ichigo-6301/mrtc-radar-tensor-codec-open/docs/en/architecture.md

# Architecture

[中文](../zh-CN/architecture.md) · [Back to README](../../README.en.md)

## System Contract

RDTC consumes Range-Doppler-Beam data produced by the FFT backend and sits between sensing-data generation and off-chip storage or transport; it does not implement the upstream FFT. Hardware implementation and performance optimization are encoder-centric, with packets intended for DDR, interconnect, or PC upload. A receiving PC/C decoder can reconstruct original I/Q from conventional self-describing packets. The RTL decoder provides protocol closure, bit-exact loopback, malformed-packet checking, and a hardware-decoder reference; no claim requires a production ASIC to instantiate it.

OFDM sensing and RDTC system context

| Contract | Public reference configuration |
|---|---|
| Block | `1024` I16Q16 samples and `4096` raw bytes |
| Packet | 64-byte self-describing header + RAW/Rice payload |
| Stream | main interface is 128-bit AXI-Stream; TLAST ends a packet and TUSER gives final-beat byte count |
| Identity | Frame, Block, and Range metadata preserve packet identity |
| Reconstruction | PC/C decodes conventional header-length packets; RTL decoding supplies bit-exact verification and a hardware reference |

See [Interfaces](interfaces.md) and [Bitstream Format](bitstream_format.md) for the external contract.

| Architecture layer | Published RTL |
|---|---|
| Complete control surface | [`mrtc_top`](../../rtl/top/mrtc_top.sv) plus [`mrtc_axi_lite_reg_block`](../../rtl/top/mrtc_axi_lite_reg_block.sv) |
| Single-Engine codec | [`mrtc_rdtc_codec_top`](../../rtl/rdtc/mrtc_rdtc_codec_top.sv) |
| DDR Multi-Engine | [`mrtc_rdtc_ddr_multiengine_wrapper`](../../rtl/rdtc/mrtc_rdtc_ddr_multiengine_wrapper.sv) |
| Bounded Direct-AXIS dual Engine (opt-in) | [`mrtc_rdtc_bounded_axis_multiengine_wrapper`](../../rtl/rdtc/mrtc_rdtc_bounded_axis_multiengine_wrapper.sv) |
| AXIS32 FPGA adaptation | [`mrtc_rdtc_axis32_wrapper`](../../rtl/rdtc/mrtc_rdtc_axis32_wrapper.sv) |

## Historical Full-Block Single-Engine Pipeline

Historical full-block/ping-pong Single-Engine encoder and decoder pipeline

The figure and this section describe the historical full-block/ping-pong profile, not the current bounded Direct-AXIS four-way shallow ring. They explain the stages used by the Lane4 Bitpacker and buffered Multi-Engine evidence.

A Single Engine progresses through these stages:

1. **Capture**: AXI input captures a complete block; ping-pong banks overlap reception of the next block with computation on the current block.
2. **Predict and map**: the block configuration selects ZERO or DELTA prediction, and I/Q residuals are independently mapped to non-negative values.
3. **Cost and select**: the prefix accumulator evaluates candidate `k` values, and the block policy selects `k`; only supporting encoder paths may fall back to RAW.
4. **Pack and frame**: the lane-parallel bitpacker emits the variable-length payload, while the header generator writes mode, length, and Frame/Block metadata.
5. **Decouple output**: the packet buffer isolates computation from AXI backpressure while preserving packet content and boundaries.
6. **Decode**: the header parser validates the format, and the Decoder reconstructs residuals and I/Q using the exact payload-bit count.

The DDR-backed `mrtc_rdtc_encoder_top` supports coding-cost-based RAW fallback. The small-buffer lane used by the AXIS32 wrapper has internal RAW fallback disabled. The architecture therefore presents RAW fallback as a path-dependent capability, not a universal wrapper guarantee.

## Descriptor/DDR Multi-Engine Wrapper

Descriptor and DDR-backed MRTC-RDTC Multi-Engine architecture

The Multi-Engine wrapper addresses system throughput when Single-Engine latency depends on block data:

- the round-robin dispatcher assigns complete blocks and never splits block-local state;
- every Engine has an independent feeder, codec state, and packet buffer;
- once the arbiter selects a packet, it holds the grant through that packet's `tlast`;
- beats from different packets do not interleave, while packet completion order may vary;
- header metadata preserves Frame/Block identity for indexed reconstruction at the consumer.

### Ordering Contract

| Property | Guarantee |
|---|---|
| Packet atomicity | verified: no beat interleaving within a packet |
| Input-order preservation | not guaranteed; data-dependent encoded length may change completion order |
| `OUTPUT_IN_ORDER=1` | not implemented; the public smoke requires this configuration to fail fast |
| Observed reorder event | the recorded workload did not directly observe one, so no triggered-reorder claim is made |
| Software reorder | metadata supports indexed reconstruction, but no software implementation PASS is claimed |

This choice avoids the buffering, control complexity, and head-of-line blocking of a hardware reorder buffer while leaving ordering policy explicit at the system-integration layer.

## Bounded Direct-AXIS Profile

Current bounded Direct-AXIS dual-Engine architecture

The opt-in Direct profile targets a lower-storage path for a bounded signal domain. One AXIS128 source sends 256 beats per block. A two-entry job table assigns complete blocks strictly to Engine 0, then Engine 1, while output remains input-job ordered and packet-locked through `tlast`.

Each Engine contains four `32x128` true-1RW ways, a two-entry registered ingress queue, a prefix-128 estimator, and the fixed-rate bounded bitpacker. The estimator observes accepted input directly and does not consume the RAM read port. The wrapper removes the DDR feeder and per-Engine payload commit stores; a global 16-beat FIFO absorbs short output stalls. The two Engines therefore contain `32,768` bulk ring bits, versus the prior payload-backed experiment's `180,224` bulk bits.

### Four-Way Shallow Input Ring

Bounded Direct-AXIS four-way shallow input ring

This ring belongs only to the bounded Direct-AXIS Encoder. It sits between AXIS input capture and the Bitpacker; it is neither an output FIFO nor the historical full-block ping-pong buffer. Each Engine holds `4 ways x 32 words x 128 bits = 2048 bytes`, exactly half of a 4096-byte block. The prefix estimator observes accepted input directly. `prefix-128` means the first 128 complex samples, or 32 AXIS128 beats, and is distinct from the ring's 128-beat capacity.

For a zero-based global AXIS word index:

```text
way    = floor(global_word_index / 32) mod 4
offset = global_word_index mod 32
```

| Global word | Physical way | Action |
|---|---:|---|
| `0-31` | 0 | first fill |
| `32-63` | 1 | first fill |
| `64-95` | 2 | first fill |
| `96-127` | 3 | first fill |
| `128-159` | 0 | reuse released slots |
| `160-191` | 1 | reuse released slots |
| `192-223` | 2 | reuse released slots |
| `224-255` | 3 | reuse released slots |

On a legal, non-fatal capture, each accepted input word writes its mapped slot and sets valid. An accepted ring read clears that slot's valid state so a later wrap can reuse it. The external response arrives at a fixed two-clock delay from the read request. Reads and writes may overlap on different ways. A true-1RW way cannot read and write in the same cycle even at different offsets; that condition raises a way conflict. Writing a still-valid slot or reading an invalid slot raises a ring error, promoted by the bounded Encoder to sticky fatal status.

### From An AXIS128 Source Word To A Variable Fragment

```text
ring response
    |
    v
P0   : accept one AXIS128 word / 4 complex samples
    |
P1R  : predictor selection and 8 signed residuals
    |
P1   : 8 residuals -> unsigned mapped symbols
    |
P2   : quotient, remainder and 8 component lengths
    |
P2S  : total length + parallel suffix-sum placement offsets
    |
P3A/P3P/P3B
     : unary/terminator/remainder generation
     : dynamic placement
     : balanced OR-tree token assembly
    |
    v
128-bit variable fragment + fragment length
    |
    v
width packer bit reservoir
    |
    v
bit-contiguous AXIS128 payload stream
```

The current bounded Direct profile fixes the ZERO predictor. Each signed 16-bit component passes through predictor selection and subtraction in P1R into a signed 18-bit residual container, then P1 maps it to an unsigned 18-bit symbol. P2 calculates all eight components' quotients, remainders, and `q+1+k*` lengths in parallel. P2S uses a logarithmic-depth suffix-sum structure to calculate total token length and each component's placement offset. P3A/P3P/P3B divide unary/terminator/remainder generation, dynamic shifts, and the wide balanced OR reduction across registered stages. The final 128-bit fragment carries an explicit bit length.

The width packer appends adjacent fragments to its bit reservoir. It emits a full AXIS128 payload word whenever at least 128 bits are available and emits a padded partial tail word at packet end. Fragment boundaries have no byte alignment. Source ring-read requests can therefore run at `II=1` while the compressed output still contains legal `TVALID` bubbles.

The per-source-word guard ensures that one source word never requires more than one 128-bit fragment in the bounded domain, allowing a one-word-per-cycle source cadence. If the total exceeds 128 bits, the Encoder reports `MRTC_ERR_BOUNDED_RICE_WORD` and fail-stops; it does not switch to RAW automatically.

The first 32 accepted AXIS128 beats contain the 128-sample prefix. During capture, the estimator accumulates `q+1+k` for every I/Q component and every candidate `k=0..15`, then selects the minimum accumulated prefix cost as `k*`; those first 32 beats remain in the ring. After `k*` becomes valid, the Bitpacker reads all 256 source words in original order, including the first 32 beats, and continues checking the per-word `<=128-bit` guard across the full block.

### Stream Timing Contract

See [Stream Timing](stream_timing.md#protocol-timing-contract) for the complete protocol relationship, the fixed Engine 0 / Block 0 ModelSim trace, payload bubbles, two deterministic backpressure holds, and dual-Engine packet-lock. That page separates ring-read source `II=1` from compressed-output `TVALID` duty and links the public CSV/Evidence directly.

This simplification is deliberately fail-stop:

- only `ZERO_RICE` with block-adaptive prefix `k` is accepted;
- every source-word fragment containing eight I/Q components must fit in `128` bits;
- one Engine issues all 256 ring reads at `II=1` after `k` becomes available;
- a same-way read/write collision, cadence failure, malformed block, or exhausted output credit raises sticky fatal status;
- without speculative payload storage, a fatal event can leave a partial packet externally visible, so producer and receiver state must be reset together.

The fixed regression observes about `277 cycles` of ordered packet service for a block arriving every `256 cycles`. That deficit accumulates and eventually triggers the illegal same-way condition reported as `MRTC_ERR_SRAM_WAY_CONFLICT`. This is workload evidence, not a protocol-cycle guarantee. The profile verifies bounded datapath behavior and implementation closure, but does not verify sustained zero-gap scheduling.

## Historical Buffered Throughput Scaling

The historical fixed-commit 256-block workload uses the Stage16D2 `785 cycles/block` single-Engine result as its same-workload reference. The 2/4-Engine buffered-wrapper runs achieve `397.52 / 197.41 cycles/block`, with efficiencies of `98.7368% / 99.4115%`. The 1-Engine reference was not rerun through the wrapper with `NUM_ENGINES=1`; one beam is defined as 256 blocks in this record.

Historical buffered Multi-Engine RTL simulation scaling

At an assumed 200 MHz, unrounded total-cycle values in the CSV project `1965.3022 / 3957.4642 beam/s`. These are RTL simulation projections, not FPGA implemented timing, measured board DDR throughput, or network throughput. The current public adaptation runs only a 2-Engine, 2-block correctness smoke and does not recompute the historical performance matrix.

Sources: [Multi-Engine evidence](../../evidence/rdtc_v1_multiengine_rtl.yaml) · [public CSV](../../evidence/data/rdtc_v1_multiengine_scaling.csv)

## Memory-Implementation Boundary

The historical `register-expanded` and `sram-macro` profiles preserve the same external AXI, packet, and functional contract while changing the prefix/sample-buffer binding. The Direct profile applies the same principle specifically to its eight `32x128` way memories: either all eight are expanded into standard cells or all eight bind to 1RW OpenRAM macros. The 16-beat output queue and control state remain registers. A memory-binding change does not remove buffering behavior or change packet bytes.

[See ASIC implementation and profile maturity](asic_implementation.md)
