ichigo-6301/mrtc-radar-tensor-codec-open/docs/zh-CN/interfaces.md

# 接口与集成入口

[English](../en/interfaces.md) · [返回首页](../../README.md)

## 应该实例化哪个模块

| 使用场景 | Canonical top | Filelist | 公开检查 |
|---|---|---|---|
| 完整受控 IP，AXI4-Lite 配置 + AXIS128 codec | [`mrtc_top`](../../rtl/top/mrtc_top.sv) | [`rdtc_v1.f`](../../flows/manifests/rdtc_v1.f) | `make integration-smoke` |
| 单 Engine 编码器 + 解码器 | [`mrtc_rdtc_codec_top`](../../rtl/rdtc/mrtc_rdtc_codec_top.sv) | [`rdtc_v1.f`](../../flows/manifests/rdtc_v1.f) | `make integration-smoke`；实例参考 [`tb_rdtc_codec_top_smoke`](../../tb/sv/tb_rdtc_codec_top_smoke.sv) |
| Descriptor/DDR feeder 驱动的 N Engine 压缩 | [`mrtc_rdtc_ddr_multiengine_wrapper`](../../rtl/rdtc/mrtc_rdtc_ddr_multiengine_wrapper.sv) | [`rdtc_v1_multiengine_smoke.f`](../../flows/manifests/rdtc_v1_multiengine_smoke.f) | `make multiengine-smoke` |
| 单路 AXIS128 输入的 bounded 双 Engine | [`mrtc_rdtc_bounded_axis_multiengine_wrapper`](../../rtl/rdtc/mrtc_rdtc_bounded_axis_multiengine_wrapper.sv) | [`rdtc_v1_bounded_direct.f`](../../flows/manifests/rdtc_v1_bounded_direct.f) | `make bounded-direct-rtl-smoke` 与 `make bounded-direct-rtl-identity-check` |
| 历史 Zynq trial 的 AXIS32 adaptation | [`mrtc_rdtc_axis32_wrapper`](../../rtl/rdtc/mrtc_rdtc_axis32_wrapper.sv) | [`rdtc_v1_fpga_wrapper_smoke.f`](../../flows/manifests/rdtc_v1_fpga_wrapper_smoke.f) | `make fpga-wrapper-smoke` |

通用新集成默认从 `mrtc_top` 开始；只需要 codec datapath、并由外部逻辑直接提供配置时使用 `mrtc_rdtc_codec_top`。DDR 与 bounded Direct-AXIS wrapper 都是 opt-in 集成面，并不替代带 AXI4-Lite 控制面的 `mrtc_top`。

## 固定数据合同

| 项目 | RDTC v1 合同 |
|---|---|
| 原始 sample | I16Q16 complex，I/Q 各为 signed 16-bit |
| Tensor flatten | `S[spatial/beam, doppler, range]`；Range 最快变化；由 producer 形成扁平序列 |
| Block | 1024 complex samples，4096 raw bytes |
| 主 datapath | 128-bit AXI-Stream，每拍 4 个 I16Q16 sample |
| Sample word | 每个 32-bit lane 为 `{Q[15:0], I[15:0]}`；字节为 little-endian I 后 Q |
| Packet | 64-byte little-endian header + variable-length payload |
| Codec mode | `RAW_BYPASS`、`ZERO_RICE`、`DELTA_RICE` |
| Tail bytes | TLAST 拍使用 `tuser[3:0] = valid_byte_count - 1`；主 AXIS128 不导出 TKEEP |

## Clock 与 Reset

公开 RTL 使用单一 `clk` 和低有效异步 datapath reset `rst_n`。`i_clear_status` 只清 completion/counter 统计，不清 sticky fatal status、不替代 reset，也不应被用来中断正在握手的 AXI-Stream transaction。所有 `tvalid/tready` 传输都在 `clk` 上升沿完成。

## AXI-Stream 编码 transaction

1. 在 block 第一个 beat 前锁定 codec、Rice 和 tensor metadata 配置。
2. 仅当 `s_axis_raw_tvalid && s_axis_raw_tready` 时提交输入 beat。
3. 按零起始编号，在 beat 255（第 256 拍）置 `s_axis_raw_tlast=1`；该 beat 仍包含 4 个有效 I16Q16 sample。
4. Encoder 先发送 64-byte header，再发送 payload。
5. 最后一个输出 beat 置 `m_axis_comp_tlast=1`，此时 `m_axis_comp_tuser[3:0]` 给出有效字节数减一；完整 16-byte 尾拍为 `15`。
6. 在正常非 fatal 路径，下游可以拉低 `m_axis_comp_tready`，packet 内容和边界保持到握手；fail-stop halt 是下文明确说明的例外。

Decoder 在 `s_axis_comp_*` 接收同一物理 packet 边界，并在 `m_axis_raw_*` 恢复 1024 个 I16Q16 sample。常规 C/RTL packet 由 header 给出 payload length；bounded Direct packet 由 TLAST/TUSER 给出物理长度。两者兼容性和当前 C decoder 缺口见[码流格式](bitstream_format.md#packet-length-contracts)。固定示例可运行 `make codec-demo`，其输入、packet 和解码输出 SHA256 记录在 [codec demo evidence](../../evidence/rdtc_v1_codec_demo.yaml)。接口握手与 Direct packet 服务时序见[流时序](stream_timing.md#protocol-timing-contract)。

## 关键参数

| Module | Parameter | 含义 |
|---|---|---|
| `mrtc_top` | `AXIS_DATA_W=128` | 公开主数据宽度；当前 RDTC v1 合同固定为 128 bit |
| `mrtc_top` | `AXIL_ADDR_W=12`, `AXIL_DATA_W=32` | 控制面地址与数据宽度 |
| codec/engine | `MRTC_K_POLICY_ARCH` | full-adaptive 或 prefix-fast `k` 选择架构 |
| 常规 codec/top 与历史 full-block profile | `PREFIX_SAMPLES=256` | 该路径的公开默认 prefix-fast 观察长度；不适用于 Direct profile |
| DDR wrapper | `NUM_ENGINES=2` | Engine 数量；公开回归覆盖 2/4 Engine 历史矩阵与 2 Engine adaptation smoke |
| DDR wrapper | `OUTPUT_IN_ORDER=0` | 唯一支持值；设为 `1` 会 fail-fast |
| Direct wrapper | `NUM_ENGINES=2`, `ENGINE_BOUNDED_WAY_COUNT=4` | 公开配置固定为双 Engine、共 8 个 way |
| Direct wrapper | `PREFIX_SAMPLES=128`, `OUTPUT_FIFO_DEPTH=16` | 固定 bounded prefix 与全局 output credit 深度 |

## Multi-Engine descriptor 与输出顺序

DDR wrapper 通过 `s_desc_*` 接收 raw address、Frame/Block ID、Range 起点、codec mode 和 tensor shape。每个 Engine 拥有独立 feeder、codec 和 packet buffer；输出 arbiter 一旦选中 packet，就保持该 Engine 直到 `tlast`，因此 packet 内不会 beat interleaving。

不同 block 的完成顺序不保证。Header 中的 Frame/Block metadata 提供 indexed software reconstruction 所需身份，但本仓库不声明软件 reorder 程序 PASS。`OUTPUT_IN_ORDER=1` 未实现并显式 fail-fast。

## Bounded Direct-AXIS 合同

Direct wrapper 分别接收 descriptor 与单路 `s_axis_raw_*`。Descriptor 包含 Block ID、Range 起点、Frame ID、tensor dimensions、codec/Rice 字段和 `last_block`，不包含 raw DDR 地址。每个 descriptor 精确预约一个 Engine，随后 256 个已握手 AXIS128 beat 全部属于该 descriptor；没有预约 descriptor 就发送数据属于 fatal。

公开合法配置为 `ZERO_RICE` 加 block-adaptive prefix `k`。RAW、DELTA、fixed `k`、过早/过晚 `tlast`、超过 128 bit 的 Rice word、`II=1` cadence 中断或同 way 读写冲突都会 fail closed。Descriptor 严格按 Engine `0 -> 1 -> 0 -> 1` 轮转；输出保持 job-table 顺序，并锁定到已握手的 `m_axis_comp_tlast`。Packet 内允许 `tvalid` 空拍，`tlast` 仍是唯一 packet boundary。

Direct 输入面是 bounded fail-stop 合同：当已预约 Engine 尚未 ready 时继续呈现 `s_axis_raw_tvalid=1` 会产生 `MRTC_ERR_BLOCK_NOT_READY`，而不是作为可无限保持的普通输入 backpressure。Producer 必须先完成合法 descriptor 预约，并只在该 Direct wrapper 允许的 ready 窗口送数。四路 ring 的容量、复用与冲突规则见[架构](architecture.md#four-way-shallow-input-ring)。

16-beat output FIFO 提供有限 backpressure credit。下游 stall 耗尽 emergency credit 后，`stat_error` sticky 为 `MRTC_ERR_OUTPUT_CREDIT`（`24`），wrapper 停止接收和输出。该路径没有 speculative payload commit store，已发送 beat 不能回滚；恢复必须用真实 `rst_n` 同时复位 wrapper 与下游 packet receiver。`i_clear_status` 只清 counter，不能恢复 fatal 状态。

## AXI4-Lite 控制面

`mrtc_top` 的 AXI4-Lite 接口提供 enable、soft reset、状态清除、codec 配置、tensor metadata、计数器、IRQ 和 capability。地址、位域和读写属性见 [寄存器表](register_map.md)；RTL [`mrtc_axi_lite_reg_block`](../../rtl/top/mrtc_axi_lite_reg_block.sv) 是最终接口权威。

## 集成检查清单

- 固定配置在一个 block transaction 内保持不变。
- 输入 `tlast` 与 1024-sample block 边界一致。
- 正常非 fatal 输出路径支持 `tready` backpressure 与 TLAST/TUSER 尾拍规则；Direct output-credit 耗尽属于 fail-stop，不是无限 backpressure。
- Packet 以 `tlast` 为原子边界，不按 block ID 假设天然有序。
- Direct profile 必须先提交合法 descriptor、满足 bounded codec 域、避免在低 ready 时呈现 input valid，并在任意非零 `stat_error` 后复位两端。
- 使用所选 top 对应的 tracked filelist，不手工遗漏 package 或 helper module。
- 在交付前运行对应 smoke，并确认工作树在 ignored build 产物之外保持干净。
