ichigo-6301/mrtc-radar-tensor-codec-open/vectors/rdtc_v1/smoke_axis_packing/README_vector.md

# smoke_axis_packing

RDTC v1 vector set with sample-major IQ Rice payload layout.

- Blocks: 1
- Total compressed bytes: 1470
- Raw bypass blocks: 0
- Compressed ZERO_RICE/DELTA_RICE blocks set MRTC_FLAG_SAMPLE_MAJOR_IQ.
- Case-level AXI control files use 128-bit words with per-word num_bytes and tlast.
