ichigo-6301/mrtc-radar-tensor-codec-open/vectors/rdtc_v1/smoke_random_noise/README_vector.md

# smoke_random_noise

RDTC v1 vector set with sample-major IQ Rice payload layout.

- Blocks: 1
- Total compressed bytes: 4160
- Raw bypass blocks: 1
- Compressed ZERO_RICE/DELTA_RICE blocks set MRTC_FLAG_SAMPLE_MAJOR_IQ.
- Case-level AXI control files use 128-bit words with per-word num_bytes and tlast.
