ichigo-6301/mrtc-radar-tensor-codec-open/evidence/rdtc_v1_bitpacker_pipeline_ab.yaml

title: RDTC v1 historical Bitpacker pipeline fixed-workload RTL A/B
status: verified
source_visibility: private_fixed_commits
public_evidence_scope: curated two-point payload and single-Engine steady-state CSV, fixed source/workload identities, metric derivations, and fresh ModelSim replay hashes
curated_data: evidence/data/rdtc_v1_bitpacker_pipeline_ab.csv
curated_data_sha256: 7836af2603305125d29bc30942bbf2a16bcfbaa2eb664d41cdcd36c07f28309d
tool: ModelSim SE-64 2020.4
workload:
  name: smoke_zero_sparse
  input: vectors/rdtc_v1/smoke_zero_sparse/axis_raw_in.hex
  input_sha256: db8e83367cd0219edd004d3f1ad4e35099afd5b906d6e26f4f976ca9affe4b46
  manifest: vectors/rdtc_v1/smoke_zero_sparse/manifest.json
  manifest_sha256: 1924010e24a27805b452039c62985b727b3356cc625f93539c115c3969b6c1cc
  expected_packet: vectors/rdtc_v1/smoke_zero_sparse/axis_comp_expected.hex
  expected_packet_sha256: 99dbb08d3df40b67653d1f4cb8500fe44e8f93a0e2ddf23f901678bca04d2ef9
  monitor_path: tb/sv/mrtc_encoder_latency_monitor.sv
  baseline_monitor_git_blob: f994a0b4f820b698bcc229d2cd6f4f0d06075f18
  optimized_monitor_git_blob: f994a0b4f820b698bcc229d2cd6f4f0d06075f18
metric_definition:
  name: payload_stream_cycles
  formula: packet_last_cycle - payload_first_valid_cycle + 1
  interval: inclusive
  packet_last_event: accepted packet TLAST
steady_state_metric_definition:
  name: single_engine_steady_state_cycles_per_block
  formula: average packet-completion spacing over the fixed 256-block stream
  interval: packet_last_cycle[n] - packet_last_cycle[n-1]
  scope: single Engine with prefix-during-capture enabled at both A/B points
steady_state_workload_identity:
  source_case: smoke_zero_sparse
  source_tree_git_sha: 2f361efc2ff32115d7cc2037d0bc7939da6d5d92
  identical_source_tree_at_commits:
    baseline: 327c463896bda94c60eb2b47d3c3dfc61a183367
    optimized: 2c1d9a75d2742659b604dd3f9c754096e196d132
    multiengine: 8628ee4d561bf4ee4a97a02c800e1c52c9e9a28a
  source_vector_path: vectors/rdtc_v1/smoke_zero_sparse/block_000_axis_raw_in.hex
  source_vector_git_blob: 88135ef82cfb15c601964fe1d9072b19e22421f5
  source_vector_sha256: db8e83367cd0219edd004d3f1ad4e35099afd5b906d6e26f4f976ca9affe4b46
  source_manifest_path: vectors/rdtc_v1/smoke_zero_sparse/manifest.json
  source_manifest_git_blob: 5f3821f7e52a15edeea5b1e37c4a6eef94f507e6
  source_manifest_sha256: 1924010e24a27805b452039c62985b727b3356cc625f93539c115c3969b6c1cc
  single_engine_generator:
    path: scripts/stage16c3_gen_latency_vectors.py
    git_blob: 585d7372faa58af44ec8df32a9e65f6a5f1b6c8b
    sha256: 42fac83943b1d13c65f1cb5d1981c0b6b31837f1182092b152c768be56c681f0
    generated_case: prefix_256_block_beam
    repeat_count: 256
    identical_at_baseline_and_optimized_commits: true
  multiengine_generator:
    source_commit: 8628ee4d561bf4ee4a97a02c800e1c52c9e9a28a
    path: scripts/stage16f1_gen_vectors.py
    git_blob: 4a9ec8bc7b8b0c55b1e1277b59ba9d9f20973d60
    sha256: 87eae094f9608003efbbcbd74edcbbb245aa555cea7874b94fe626fb0e0cc42f
    generated_case: prefix_256_block_beam
    repeat_count: 256
    reuses_source_vector_and_manifest: true
  public_multiengine_binding:
    evidence: evidence/rdtc_v1_multiengine_rtl.yaml
    curated_data: evidence/data/rdtc_v1_multiengine_scaling.csv
    engine_count: 1
    workload_blocks: 256
    effective_cycles_per_block: 785.00
    measurement_scope: imported Stage16D2 single-Engine reference; not a wrapper NUM_ENGINES=1 rerun
points:
  baseline:
    branch: stage16c3-prefix-during-capture
    source_commit: 327c463896bda94c60eb2b47d3c3dfc61a183367
    mode: PREFIX_FAST_STREAM_LENGTH_CAPTURE_PREFIX
    scenario: prefix_capture_zero_sparse
    source_latency_csv: docs/reports/data/stage16c3_latency/latency_per_block.csv
    source_latency_csv_git_blob: 5caec459dc0810e3bd54e75498fe61ba2bb8d6bb
    source_latency_csv_sha256: 974f6bd134e6a706e78746252a80239006f36609da8e74a130c640150e610d5c
    source_throughput_csv: docs/reports/data/stage16c3_latency/throughput_summary.csv
    source_throughput_csv_git_blob: 799cd70c9ea61155c6825c5aa22d61299a0e1aa3
    source_throughput_csv_sha256: beb06f66ab286a66647be4ef1fd24856b1d1f1bd9a4ec4ca7055ea9279b5fd27
    payload_first_valid_cycle: 1169
    packet_last_cycle: 8861
    payload_stream_cycles: 7693
    steady_state_scenario: prefix_capture_256_block_beam
    steady_state_blocks: 256
    steady_state_cycles_per_block: 8220
  optimized:
    branch: stage16d2-integrate-lane4-bitpacker
    source_commit: 2c1d9a75d2742659b604dd3f9c754096e196d132
    mode: PREFIX_FAST_STREAM_LENGTH_CAPTURE_PREFIX_LANE4_BPACK
    scenario: prefix_lane4_zero_sparse
    source_latency_csv: docs/reports/data/stage16d2_integrated_lane4/latency_per_block.csv
    source_latency_csv_git_blob: a222dff12da80292596c21521a26213b2b260de2
    source_latency_csv_sha256: d78a04854ff297e679a7ed030edd23b90564efc8d6fc3c41b992da8dffd966e3
    source_throughput_csv: docs/reports/data/stage16d2_integrated_lane4/throughput_summary.csv
    source_throughput_csv_git_blob: 1c7e12127ee5f030d496f1cec656ef94d058e556
    source_throughput_csv_sha256: 5f4558040382b439ce688bed749f13ea69994d61fd3e8931f72e703c328f5b7a
    source_packet_compare_csv: docs/reports/data/stage16d2_integrated_lane4/lane4_vs_legacy_packet_compare.csv
    source_packet_compare_csv_git_blob: d43ae69842672c6a70d2f257848cc406951dec99
    source_packet_compare_csv_sha256: e6b01207b1c78ddf412dd62dd9f25eeeebdf2a1146ae869f09c89fc7dfa0f2ab
    payload_first_valid_cycle: 706
    packet_last_cycle: 1426
    payload_stream_cycles: 721
    steady_state_scenario: prefix_lane4_256_block_beam
    steady_state_blocks: 256
    steady_state_cycles_per_block: 785
equivalence:
  selected_k: 0
  payload_bits: 2158
  payload_bytes: 270
  packet_bytes: 334
  input_stall_cycles: 0
  output_stall_cycles: 0
  payload_byte_exact: true
  packet_byte_exact: true
  baseline_decoder_loopback: pass
  optimized_decoder_loopback: pass
derivation:
  cycle_reduction: 6972
  cycle_reduction_percent: 90.62784349408554
  speedup: 10.669902912621358
  steady_state_cycle_reduction: 7435
  steady_state_cycle_reduction_percent: 90.45012165450122
  steady_state_speedup: 10.471337579617835
fresh_replay:
  date: 2026-08-01
  tool_version: Model Technology ModelSim SE-64 vsim 2020.4 Simulator 2020.10 Oct 13 2020
  tool_executable_sha256: 011f110291dc69707d7118e8f8d712b91438e0c837f9bc10ce6bf53c1d048cfd
  baseline:
    source_commit: 327c463896bda94c60eb2b47d3c3dfc61a183367
    worktree_status: clean
    commands:
      - tb/scripts/run_stage16c3_latency_smoke.bat
      - tb/scripts/run_rdtc_encoder_prefix_during_capture_smoke.bat
    return_code: 0
    raw_scenario_csv_sha256: 816d244cf1a6f738646e8c54e4c529d26c923eec0a5837d3d825786d66b6f65e
    compile_log_sha256: 183a18d8ee1f0172b168a2eb5ed4a836f40196569100d375631903deb1cd8d82
    latency_log_sha256: 89f4095435284820bdb79514f52ecb179074a44d6bb7c92b552fb55aaa5809ac
    loopback_log_sha256: 7853c1a791d59cea8566c0e736c1a0b22397ac6c3c22bd227d39a1d13c33e2ae
  optimized:
    source_commit: 2c1d9a75d2742659b604dd3f9c754096e196d132
    worktree_status: clean
    commands:
      - tb/scripts/run_stage16d2_lane4_latency_smoke.bat
      - tb/scripts/run_rdtc_encoder_prefix_lane4_active_smoke.bat
      - tb/scripts/run_rdtc_encoder_prefix_lane4_active_loopback_smoke.bat
    return_code: 0
    raw_scenario_csv_sha256: b031a9cd9e2f8a133e76bd0acf43c854d5602eca8d5b8c4e817ab1884f0079b0
    compile_log_sha256: 7d64ff646f0ad957c99bb102e4aa1e345e478ec3a0463020d4c4f587cf481601
    latency_log_sha256: 611cea620f7ed45b79732b2978b3ca444da1cf5b0218cbcb2e02b2e8fd1d4a29
    packet_compare_csv_sha256: 520d4f91ce635b8b0ac6ec2c3f06ebe28becaea5aea115941b3c5d97b1c34951
    packet_compare_log_sha256: bb9ac4a8c7d53c862357e557077a2fb0eee1dbbe58e3beb5af53284524928613
    loopback_log_sha256: 8a00b64aa4cc0bb5170c2adcbc87c2e8758ae81a8dac8148cdcf9ecd30333197
  result: pass
result: pass
caveats:
  - The 10.6699x value is the inclusive first-payload-valid to accepted-TLAST interval on one fixed historical RTL workload.
  - The 10.4713x value is average packet-completion spacing over fixed 256-block single-Engine streams; it is not one-block latency.
  - Both A/B points retain prefix-during-capture, so the measured delta isolates the integrated Lane4 Bitpacker rather than attributing the full change to front-end ping-pong.
  - Neither metric is current Direct-AXIS sustained throughput, FPGA performance, ASIC frequency, or Fmax.
  - The 256-block workload identity closes over the common source vector/manifest and deterministic repeat generators; generated runtime directories were not committed and have no independent artifact hashes.
  - The Multi-Engine chart's one-Engine row imports the same-workload Stage16D2 reference; it is not a separate wrapper NUM_ENGINES=1 measurement.
  - Historical source commits and raw ModelSim logs remain private; this public record publishes curated values and immutable identities only.
