ichigo-6301/mrtc-radar-tensor-codec-open/tb/sv/tb_mrtc_rice_bitpacker_lane_axis.sv

`timescale 1ns/1ps

module tb_mrtc_rice_bitpacker_lane_axis;
  import mrtc_pkg::*;

  localparam int AXIS_DATA_W        = 128;
  localparam int LANES              = MRTC_LANES;
  localparam int BLOCK_SAMPLES      = MRTC_BLOCK_SAMPLES;
  localparam int BLOCK_WORDS        = BLOCK_SAMPLES / LANES;
  localparam int WORD_ADDR_W        = $clog2(BLOCK_WORDS);
  localparam int SAMPLE_ADDR_W      = $clog2(BLOCK_SAMPLES);
  localparam int AXIS_BYTES         = AXIS_DATA_W / 8;
  localparam int MAX_PAYLOAD_BYTES  = MRTC_MAX_PAYLOAD_BYTES;
  localparam int VALID_BYTE_COUNT_W = $clog2(AXIS_BYTES + 1);

  logic clk;
  logic rst_n;

  logic bank_clear;
  logic bank_wr_en;
  logic [WORD_ADDR_W-1:0] bank_wr_addr;
  logic [AXIS_DATA_W-1:0] bank_wr_data;

  logic [7:0] codec_mode;
  logic [7:0] selected_k;
  logic old_start;
  logic cand1_start;
  logic cand4_start;
  logic [(BLOCK_SAMPLES*32)-1:0] block_mem_flat;

  logic old_bank_rd_req;
  logic [WORD_ADDR_W-1:0] old_bank_rd_addr;
  logic old_bank_rd_valid;
  logic [AXIS_DATA_W-1:0] old_bank_rd_data;
  logic old_sample_rd_valid;
  logic [31:0] old_sample_rd_data;
  logic old_rd_req;
  logic [SAMPLE_ADDR_W-1:0] old_rd_addr;
  logic old_busy;
  logic old_done;
  logic [AXIS_DATA_W-1:0] old_tdata;
  logic old_tvalid;
  logic old_tready;
  logic old_tlast;
  logic [VALID_BYTE_COUNT_W-1:0] old_tvalid_bytes_minus1;
  logic [31:0] old_payload_bits_counted;
  logic [31:0] old_payload_bytes_counted;
  logic old_count_mismatch;
  logic old_overflow;

  logic cand1_rd_req;
  logic [WORD_ADDR_W-1:0] cand1_rd_addr;
  logic cand1_rd_valid;
  logic [AXIS_DATA_W-1:0] cand1_rd_data;
  logic cand1_busy;
  logic cand1_done;
  logic [AXIS_DATA_W-1:0] cand1_tdata;
  logic cand1_tvalid;
  logic cand1_tready;
  logic cand1_tlast;
  logic [VALID_BYTE_COUNT_W-1:0] cand1_tvalid_bytes_minus1;
  logic [31:0] cand1_payload_bits_counted;
  logic [31:0] cand1_payload_bytes_counted;
  logic cand1_overflow;
  logic cand1_long_unary_used;
  logic cand1_group_fallback_used;
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
