ichigo-6301/mrtc-radar-tensor-codec-open/(commit log)

2026-07-18 release: RDTC dual implementation profiles
    [axis_comp_expected_ctrl.csv, axis_raw_in_ctrl.csv, block_000_decoded_samples.csv, block_000_header.csv, block_000_input_samples.csv, block_001_decoded_samples.csv, block_001_header.csv, block_001_input_samples.csv]
2026-07-19 fix: make public flow defaults fail-safe
    [flowctl.py]
2026-07-22 evidence: add showcase provenance and checksums
    [rdtc_v1_fpga_axis32_xsim_cases.csv, rdtc_v1_matlab_lossless_snr.csv, rdtc_v1_multiengine_scaling.csv]
2026-07-23 docs: frame academic ASIC results and die geometry
2026-07-31 flow: add bounded direct public verification profiles
2026-07-31 docs: publish bounded direct closure evidence
    [rdtc_v1_bounded_direct_rtl_identity.csv]
2026-07-31 fix: preserve legacy status clear priority
    [mrtc_rdtc_ddr_feeder_engine.sv, mrtc_rdtc_ddr_feeder_engine_sync64.sv, mrtc_rdtc_ddr_multiengine_wrapper.sv]
2026-07-31 release: isolate bounded direct evidence scope
    [rdtc_v1_bounded_direct_rtl_identity.csv]
2026-07-31 fix: preserve portable legacy preflight behavior
    [rdtc_v1_bounded_direct_rtl_identity.csv]
2026-07-31 flow: add public bounded wrapper dc comparison
2026-07-31 flow: preserve bounded dc stress results
2026-07-31 fix: harden bounded dc comparison gates
    [bounded_buffered_direct_dc_ab.py, flowctl.py, test_bounded_buffered_direct_dc_ab.py]
2026-07-31 fix: isolate bounded dc comparison retries
    [bounded_buffered_direct_dc_ab.py, flowctl.py, test_bounded_buffered_direct_dc_ab.py]
2026-07-31 fix: bind dc comparison evidence to run inputs
    [bounded_buffered_direct_dc_ab.py, test_bounded_buffered_direct_dc_ab.py, test_validate_profile.py, validate_profile.py]
2026-07-31 fix: harden bounded dc comparison inputs
    [bounded_buffered_direct_dc_ab.py, flowctl.py, test_bounded_buffered_direct_dc_ab.py, test_validate_profile.py, validate_profile.py]
2026-07-31 fix: close bounded dc review gaps
    [bounded_buffered_direct_dc_ab.py, test_bounded_buffered_direct_dc_ab.py]
2026-07-31 fix: close bounded dc trust boundaries
    [bounded_buffered_direct_dc_ab.py, flowctl.py, test_bounded_buffered_direct_dc_ab.py]
2026-07-31 fix: bind complete bounded dc input set
    [bounded_buffered_direct_dc_ab.py, rdtc_v1_bounded_buffered_vs_direct_dc_ab.yaml, test_bounded_buffered_direct_dc_ab.py]
2026-08-01 evidence: publish fixed-workload bitpacker pipeline ab
    [rdtc_v1_bitpacker_pipeline_ab.csv]
2026-08-01 fix: tighten bitpacker evidence validation
    [test_validate_bitpacker_pipeline_ab.py, validate_bitpacker_pipeline_ab.py]
2026-08-01 fix: close bitpacker evidence semantic contract
    [test_validate_bitpacker_pipeline_ab.py, validate_bitpacker_pipeline_ab.py]
2026-08-01 fix: bind bitpacker csv and nonclaim semantics
    [test_validate_bitpacker_pipeline_ab.py, validate_bitpacker_pipeline_ab.py]
2026-08-03 docs: clarify single-engine and multiengine metrics
    [rdtc_v1_bitpacker_pipeline_ab.csv]
2026-08-03 docs: tighten pipeline metric provenance
    [generate_showcase_assets.py, rdtc_v1_bitpacker_pipeline_ab.yaml, rdtc_v1_multiengine_rtl.yaml, test_validate_bitpacker_pipeline_ab.py, validate_bitpacker_pipeline_ab.py]
2026-08-03 docs: explain encoder-centric data and packet contracts
2026-08-03 test: capture deterministic direct stream timing traces
2026-08-03 test: fix direct backpressure trace marker
    [tb_mrtc_bounded_axis_multiengine_wrapper.sv, test_bounded_direct_modelsim_regression.py]
2026-08-03 evidence: publish direct wrapper timing trace
    [rdtc_v1_direct_stream_timing_backpressure.csv, rdtc_v1_direct_stream_timing_nominal.csv]
2026-08-03 test: bind output trace identity to direct jobs
2026-08-03 docs: align integration docs with published timing trace
2026-08-03 docs: fix direct timing diagram layout
    [generate_showcase_assets.py, test_generate_showcase_assets.py]
2026-08-05 evidence: publish architecture power A/B review
    [classifications.csv, comparisons.csv, eligibility.csv, gates.csv, hierarchy_power.csv, points.csv, raw_reports.csv, verification.csv]
2026-08-05 release: refresh architecture power evidence checksums
2026-08-05 ci: enforce architecture power evidence gate
2026-08-05 release: refresh power review checksums after CI gate
2026-08-05 fix: harden public power evidence package
    [points.csv]
2026-08-07 evidence: publish mapped clock-gating power study
    [activity_coverage.csv, classifications.csv, clock_gating.csv, comparisons.csv, equivalence.csv, gates.csv, hierarchy_power.csv, points.csv]
2026-08-07 docs: present two-stage RDTC power optimization
2026-08-07 release: refresh two-stage power checksums
2026-08-07 docs: add coordinated RDTC performance and power figures
2026-08-07 docs: fix final performance-figure review findings
    [generate_showcase_assets.py, test_generate_showcase_assets.py]
2026-08-07 fix: close Stage-2 evidence validation gaps
    [check_public_docs.py, rdtc_clock_gating_power_evidence.py, test_rdtc_clock_gating_power_evidence.py]
2026-08-07 fix: preserve Python 3.6 documentation checks
    [check_public_docs.py]
2026-08-12 fix: close final public evidence review gaps
    [check_public_docs.py, generate_showcase_assets.py, rdtc_clock_gating_power_evidence.py, rdtc_power_2a_evidence.py, test_check_public_docs.py, test_generate_showcase_assets.py, test_rdtc_clock_gating_power_evidence.py, test_rdtc_power_2a_evidence.py]
2026-08-12 fix: close follow-up evidence review findings
    [check_public_docs.py, rdtc_clock_gating_power_evidence.py, rdtc_power_2a_evidence.py, test_check_public_docs.py, test_rdtc_clock_gating_power_evidence.py, test_rdtc_power_2a_evidence.py]
